jwpleow/CakeKiCadLib/README.md

# KiCad 7.x libraries

## Symbols

<!-- SYMBOLS START -->
| Name | Description | Datasheet | JLCPCB |
| - | - | - | - |
| CYPD3177_24x | USB Type-C and Power Delivery (PD) Controller QFN-24 | [Datasheet](https://www.infineon.com/dgdl/Infineon-EZ-PD_BCR_Datasheet_USB_Type-C_Port_Controller_for_Power_Sinks-DataSheet-v03_00-EN.pdf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) | |
| TPS23861 | 802.3at Quad Port Power-over-Ethernet PSE Controller | [Datasheet](https://www.ti.com/lit/ds/symlink/tps23861.pdf)  | [JLCPCB](https://jlcpcb.com/partdetail/TexasInstruments-TPS23861PWR/C93245) | 
| SM51625EL | LAN 10/100/1000 Base-T (PoE++) Transformer | [Datasheet](https://wmsc.lcsc.com/wmsc/upload/file/pdf/v2/lcsc/2306061201_BOURNS-SM51625EL_C5357757.pdf) | [JLCPCB](https://jlcpcb.com/partdetail/Bourns-SM51625EL/C5357757) |
| G24P02S | LAN 10/100/1000 Base-T Transformer | [Datasheet](https://wmsc.lcsc.com/wmsc/upload/file/pdf/v2/lcsc/2302141630_JASN-G24P02S_C2827276.pdf) | [JLCPCB](https://jlcpcb.com/partdetail/Jasn-G24P02S/C2827276) |
| R-RJ45R08P-C000 | RJ45, Horizontal, Shielded with LED | [Datasheet](https://wmsc.lcsc.com/wmsc/upload/file/pdf/v2/lcsc/1912111437_Ckmtw-Shenzhen-Cankemeng-R-RJ45R08P-C000_C386757.pdf) | [JLCPCB](https://jlcpcb.com/partdetail/360864-R_RJ45R08PC000/C386757) |

<!-- | GL3523-OTY30 | USB 3.1 Gen1 Hub Controller QFN-76-EP(9x9) | [Datasheet](https://datasheet.lcsc.com/lcsc/1912111437_Genesys-Logic-GL3523-OTY30_C390630.pdf) | -->
<!-- SYMBOLS END -->
