jwpleow/CakeKiCadLib/3D/NXP_SOT1092-2.stp

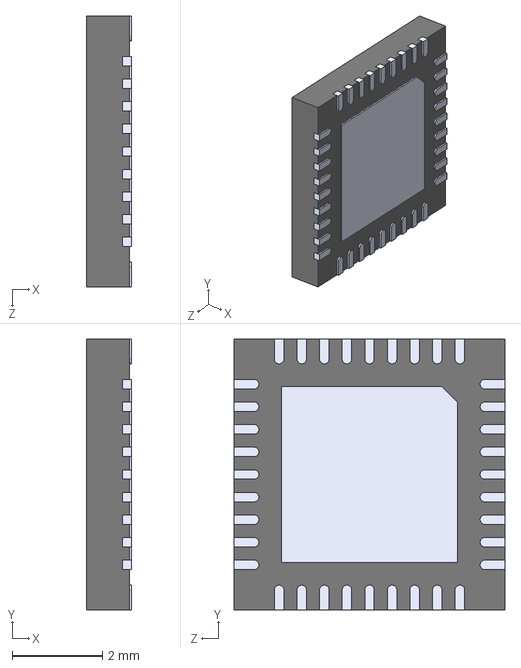
[picture p1: CAD file, 2026-05-26]
3D/NXP_SOT1092-2.stp
1.00 x 6.00 x 6.00 mm
