jwpleow/CakeKiCadLib/3D/CYPD3177-24LQXQT.stp

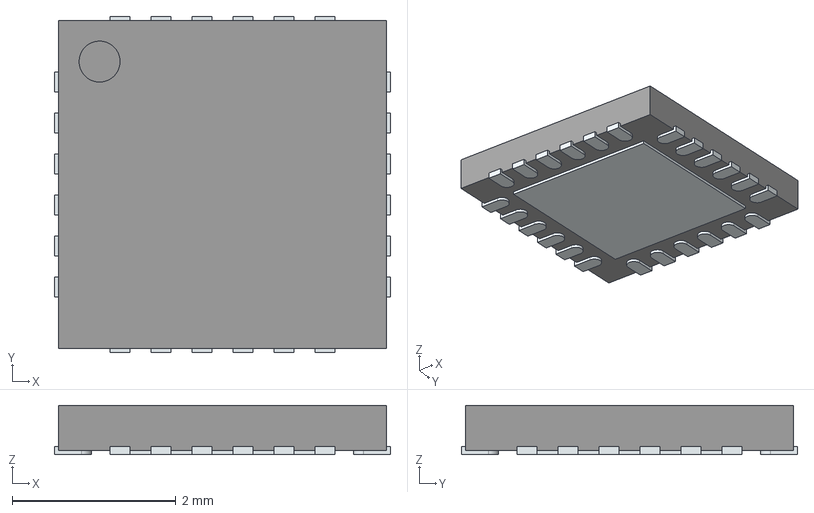
[picture p2: CAD file, 2024-08-14]
3D/CYPD3177-24LQXQT.stp
4.10 x 4.10 x 0.6 mm
ThermalPin
PinsArrayLR
PinsArrayTB
