jwpleow/CakeKiCadLib/3D/USB7216C.stp

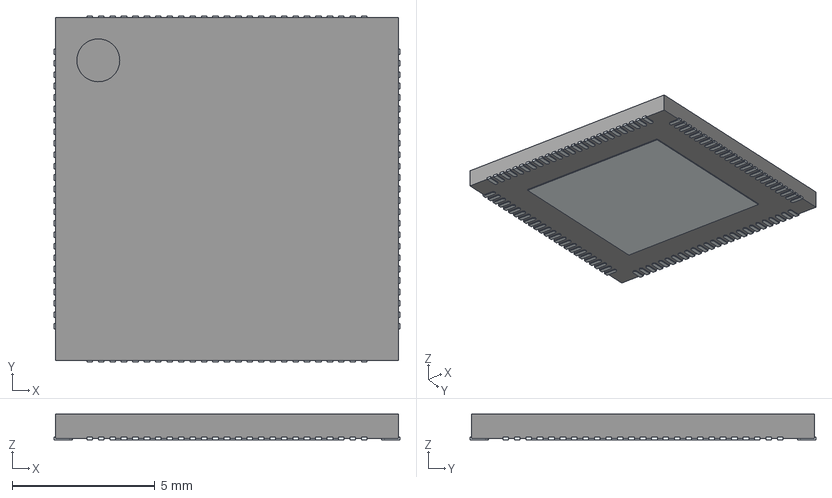
[picture p3: CAD file, 2024-08-14]
3D/USB7216C.stp
12.1 x 12.1 x 0.9 mm
ThermalPin
PinsArrayLR
PinsArrayTB
