jwpleow/CakeKiCadLib/3D/CYUSB3304-68LTXC.stp

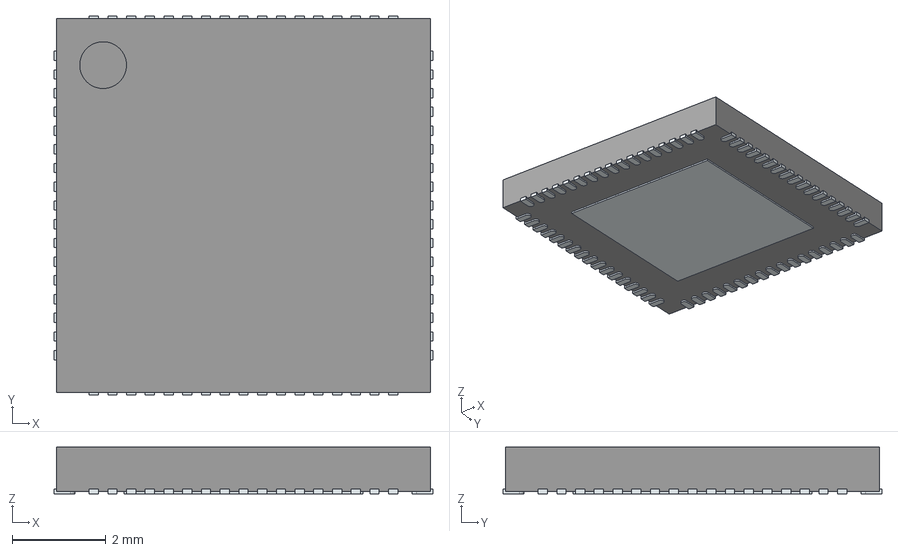
[picture p4: CAD file, 2024-08-14]
3D/CYUSB3304-68LTXC.stp
8.10 x 8.10 x 1.00 mm
ThermalPin
PinsArrayLR
PinsArrayTB
