jwpleow/CakeKiCadLib/3D/STPS3H100UF.stp

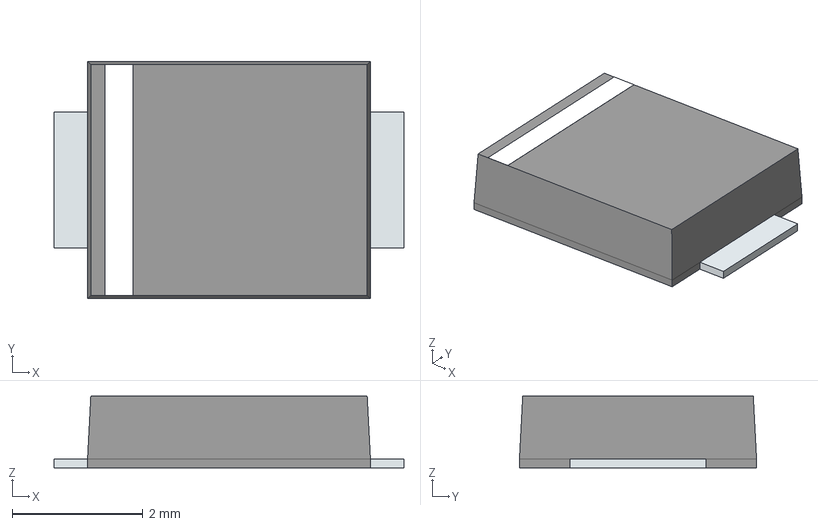
[picture p5: CAD file, 2024-08-13]
3D/STPS3H100UF.stp
5.35 x 3.62 x 1.10 mm
PinKIdent
PinK
PinA
