jwpleow/CakeKiCadLib/3D/CP_Elec_12.5x13.5.stp

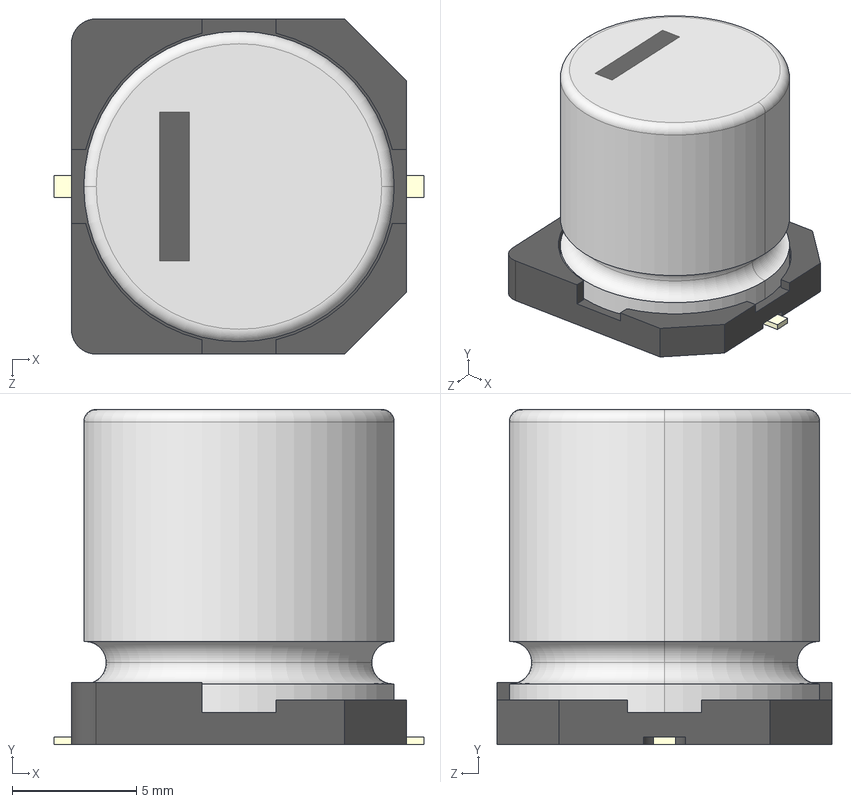
[picture p6: CAD file, 2024-08-09]
3D/CP_Elec_12.5x13.5.stp
14.9 x 13.5 x 13.5 mm
標準SIZE CODE H13-001
標準SIZE CODE H13-002
標準SIZE CODE H13-003 x 2
