jwpleow/CakeKiCadLib/3D/TPS7B8233QDGNRQ1.stp

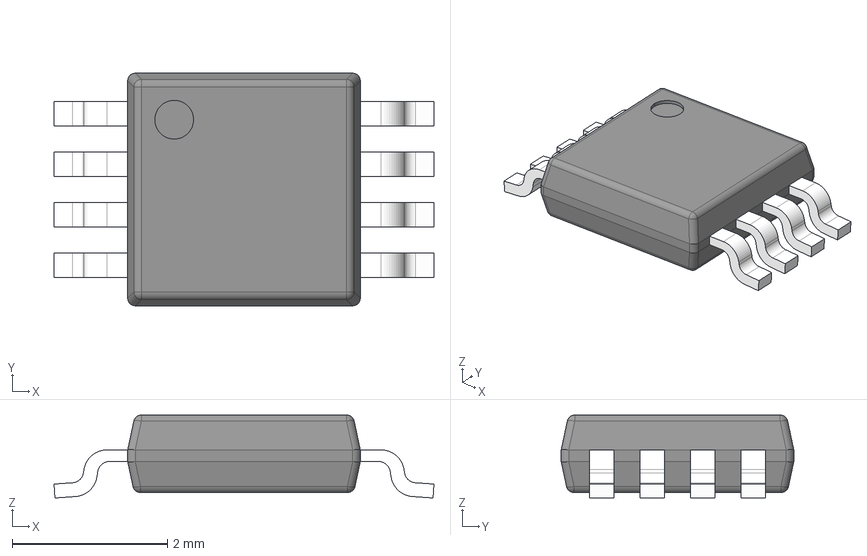
[picture p7: CAD file, 2024-08-01]
3D/TPS7B8233QDGNRQ1.stp
4.90 x 3.00 x 1.07 mm
BODY-DGN0008G
LEAD-DGN0008G x 8
PIN1_DGN0008G
DAP_DGN0008G
