jwpleow/CakeKiCadLib/3D/LM5155QDSSRQ1.stp

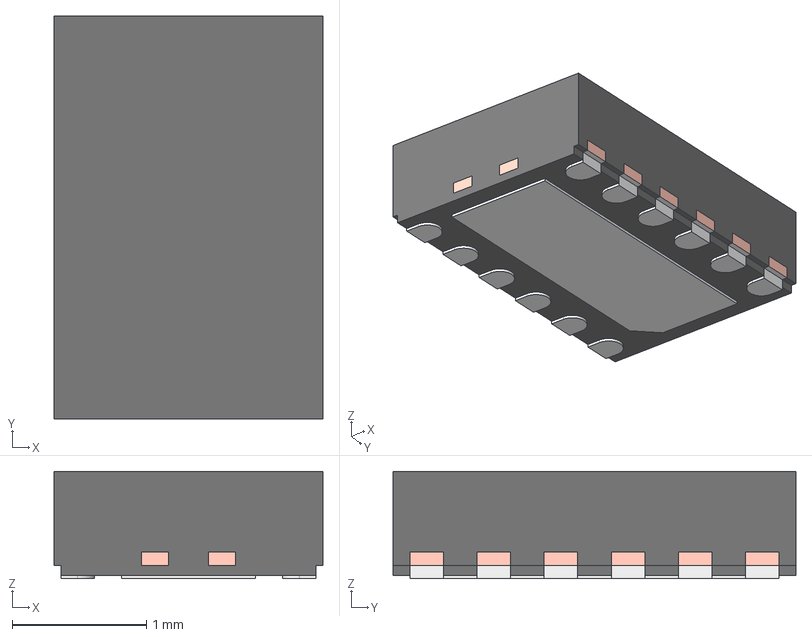
[picture p8: CAD file, 2024-08-01]
3D/LM5155QDSSRQ1.stp
2.00 x 3.00 x 0.8 mm
BODY-SON_AF0
FRAME-DSS0012C_AF0
PIN1-ID
