jwpleow/CakeKiCadLib/3D/TUSB212IRWBR.STEP

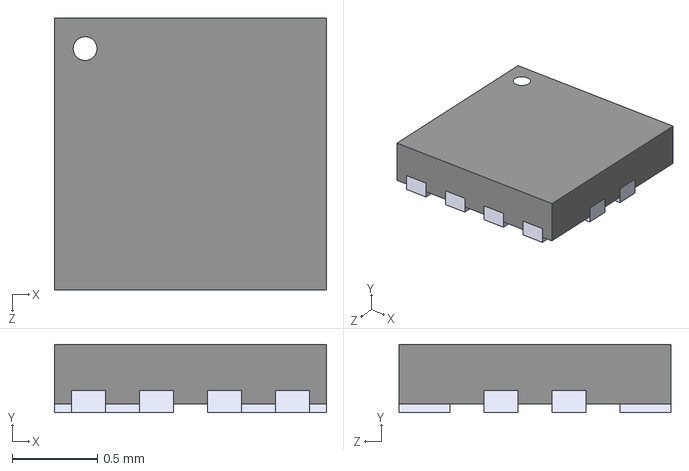
[picture p9: CAD file, 2024-07-27]
3D/TUSB212IRWBR.STEP
1.60 x 0.4 x 1.60 mm
