jwpleow/CakeKiCadLib/3D/TVS2200DRVR.stp

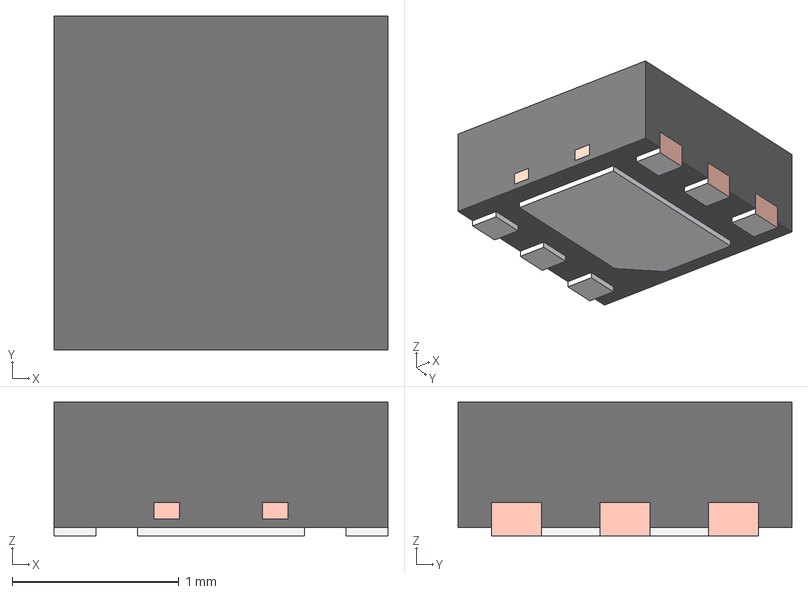
[picture p10: CAD file, 2024-07-27]
3D/TVS2200DRVR.stp
2.00 x 2.00 x 0.8 mm
BODY-SON
FRAME-DRV0006B
PIN1-ID
