jwpleow/CakeKiCadLib/3D/TUSB522Px.stp

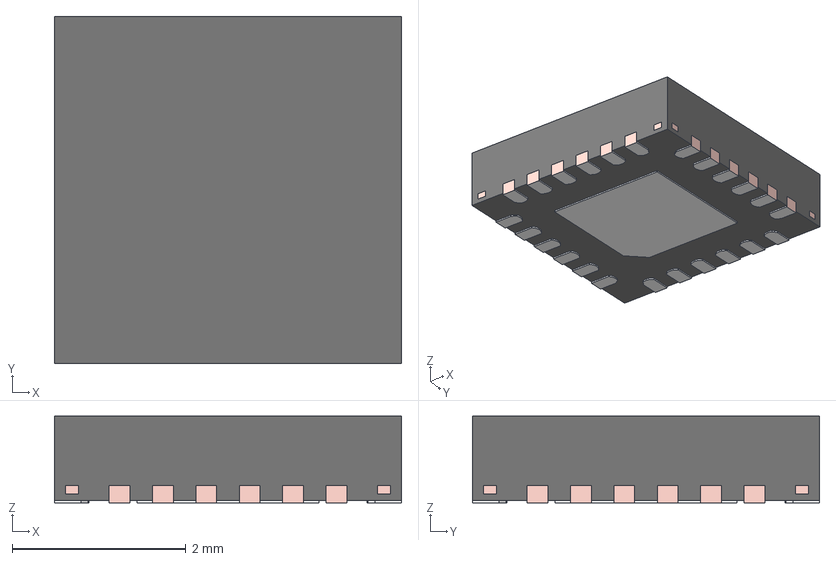
[picture p11: CAD file, 2024-07-27]
3D/TUSB522Px.stp
4.00 x 4.00 x 1.00 mm
FRAME
