jwpleow/CakeKiCadLib/3D/PUSB3FR4Z.stp

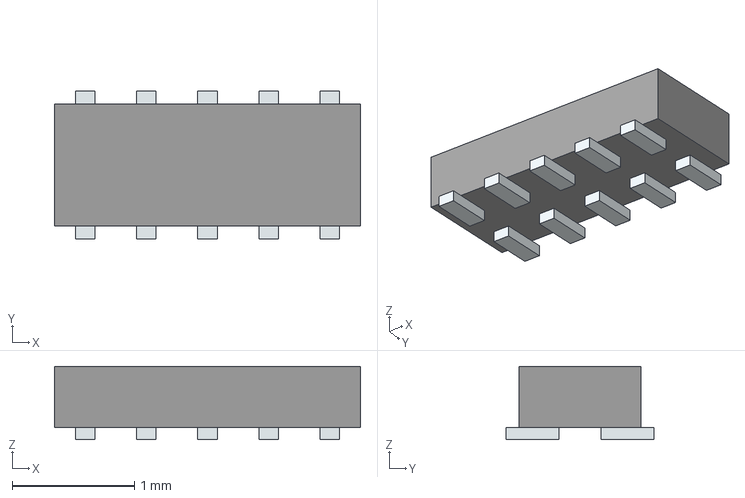
[picture p12: CAD file, 2024-07-27]
3D/PUSB3FR4Z.stp
2.50 x 1.21 x 0.6 mm
Pins
