jwpleow/CakeKiCadLib/3D/ESD122DMXR.stp

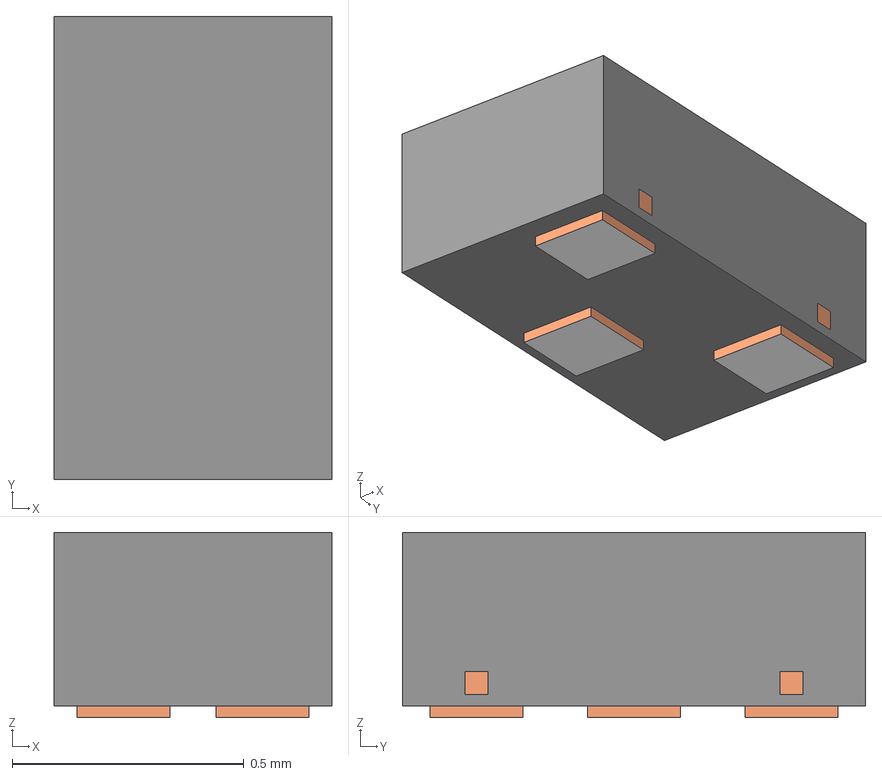
[picture p13: CAD file, 2024-07-27]
3D/ESD122DMXR.stp
0.6 x 1.00 x 0.4 mm
BODY-QFN
FRAME-DMX0003A
PIN1-ID
