jwpleow/CakeKiCadLib/3D/GT-USB-7052.STEP

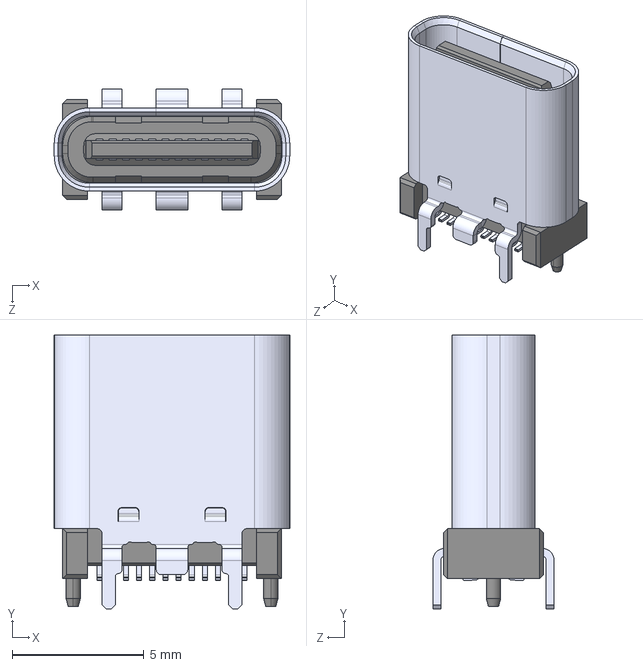
[picture p14: CAD file, 2024-07-27]
3D/GT-USB-7052.STEP
8.94 x 10.4 x 4.60 mm
