jwpleow/CakeKiCadLib/3D/PI3USB302-AZBEX.stp

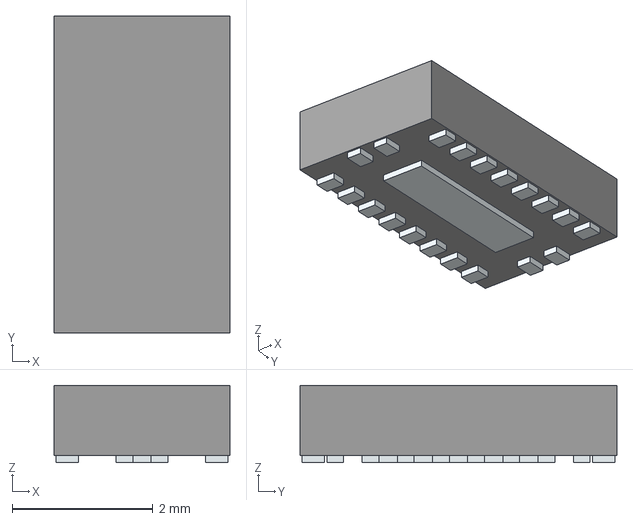
[picture p15: CAD file, 2024-07-27]
3D/PI3USB302-AZBEX.stp
2.50 x 4.50 x 1.10 mm
Pins
