jwpleow/CakeKiCadLib/3D/R-RJ45R08P-C000.stp

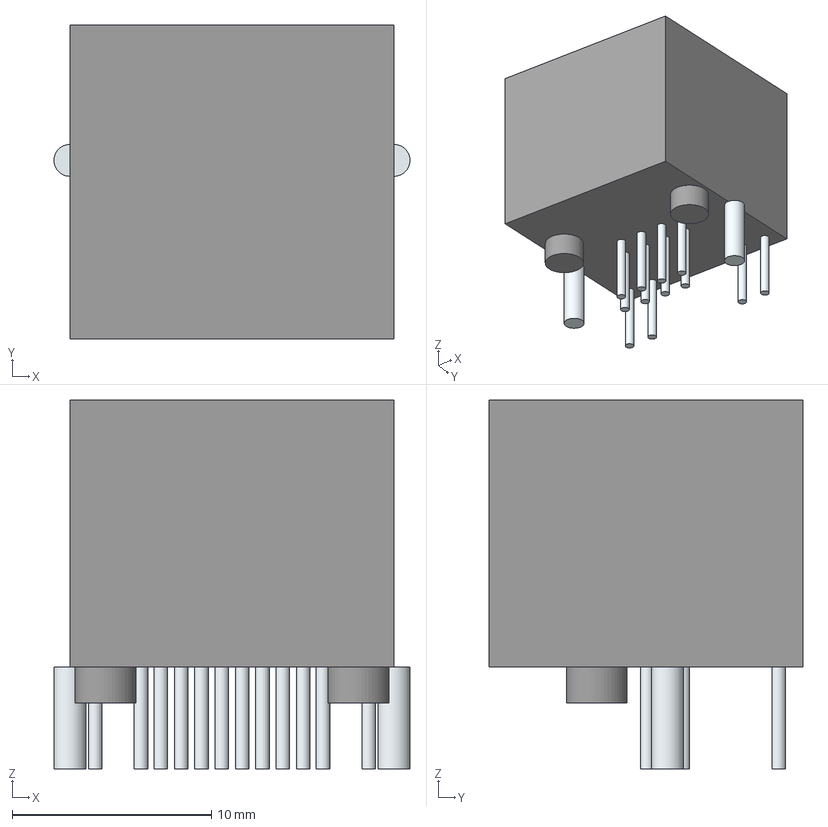
[picture p16: CAD file, 2024-07-27]
3D/R-RJ45R08P-C000.stp
17.9 x 15.8 x 18.5 mm
Lugs x 16
Leads x 16
