jwpleow/CakeKiCadLib/3D/RTL8153B-VB-CG.stp

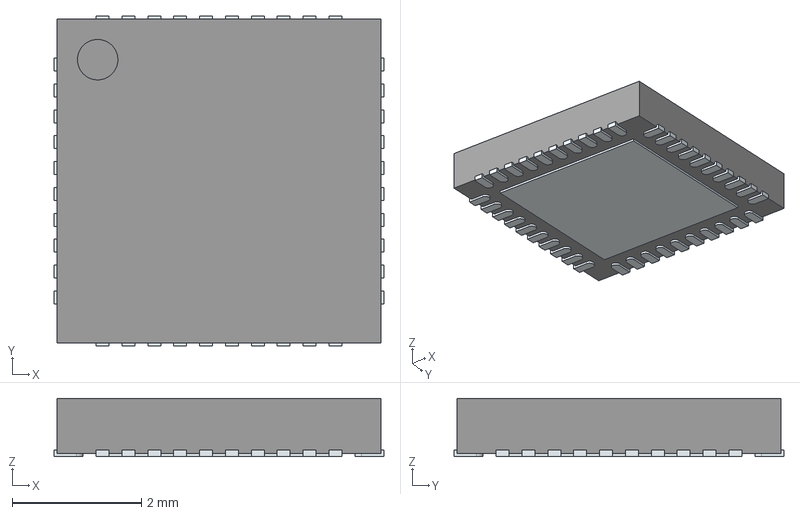
[picture p17: CAD file, 2024-07-27]
3D/RTL8153B-VB-CG.stp
5.10 x 5.10 x 0.9 mm
ThermalPin
PinsArrayLR
PinsArrayTB
