jwpleow/CakeKiCadLib/(list of files, cad)

Other CAD files:
3D/CSD19537Q3T.stp
3D/SM51625EL.stp
3D/TPS23861PWR.step
3D/TPS51396ARJET.stp
3D/TPS54331DR.stp
3D/TPS56637RPAR.stp
