jwpleow/CakeKiCadLib/(commit log)

2024-01-14 add footprint for cypd3177
2024-01-14 lengthen cypd3177 pad footprint
2024-01-14 update pin placements for CYPD3177
2024-01-20 add usb c vertical connector
2024-05-13 Add lots of stuff
    [ESD122DMXR.stp, GT-USB-7052.STEP, PI3USB302-AZBEX.stp, PUSB3FR4Z.stp, R-RJ45R08P-C000.stp, RTL8153B-VB-CG.stp, TPS51396ARJET.stp, TPS54331DR.stp]
2024-07-09 Fix links from symbols to footprint
2024-07-21 Add TPS23861
    [TPS23861PWR.step]
2024-07-27 Add some LCSC part numbers, add SM51625EL
    [ESD122DMXR.stp, GT-USB-7052.STEP, PI3USB302-AZBEX.stp, PUSB3FR4Z.stp, R-RJ45R08P-C000.stp, RTL8153B-VB-CG.stp, SM51625EL.stp, TPS23861PWR.step]
2024-08-01 Add some LDOs and boost converters
    [LM5155QDSSRQ1.stp, TPS7B8233QDGNRQ1.stp]
2024-08-09 add more symbols
    [CP_Elec_12.5x13.5.stp, CSD19537Q3T.stp]
2024-08-13 Make some footprints generic, add some 3d files
    [STPS3H100UF.stp, TVS3300DRVR.stp]
2024-08-14 Fix some footprints
    [CYPD3177-24LQXQT.stp, CYUSB3304-68LTXC.stp, USB7216C.stp]
2026-05-26 Add DP83826E and TJA1103A
    [NXP_SOT1092-2.stp]
